aIecxs/w211-airmatic/Pinout.pdf

5V

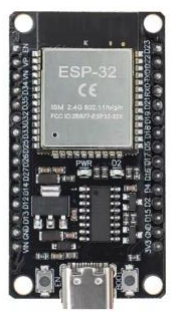
[picture p4: figure]

ESP32

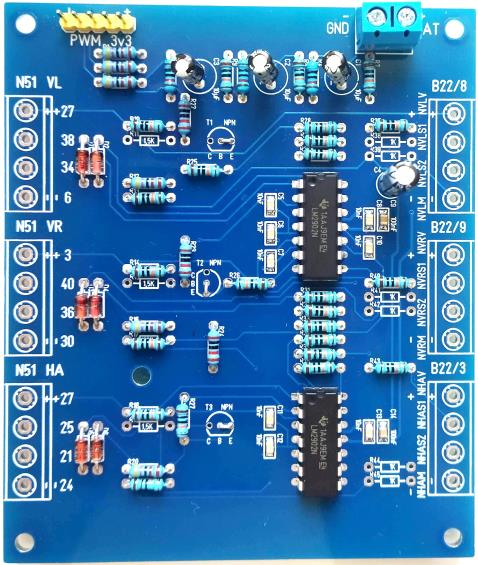
[picture p5: figure]

LM2902N

CAN-B

CAN-C

16Mhz

8Mhz

MCP2515

MCP2515

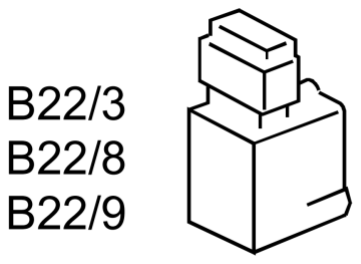
[picture p6: figure]
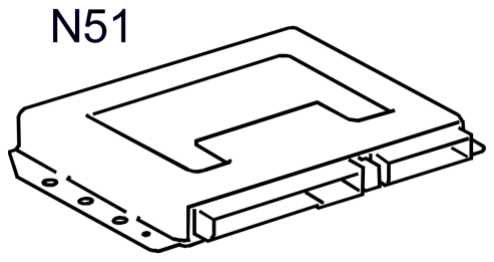
[picture p7: figure]

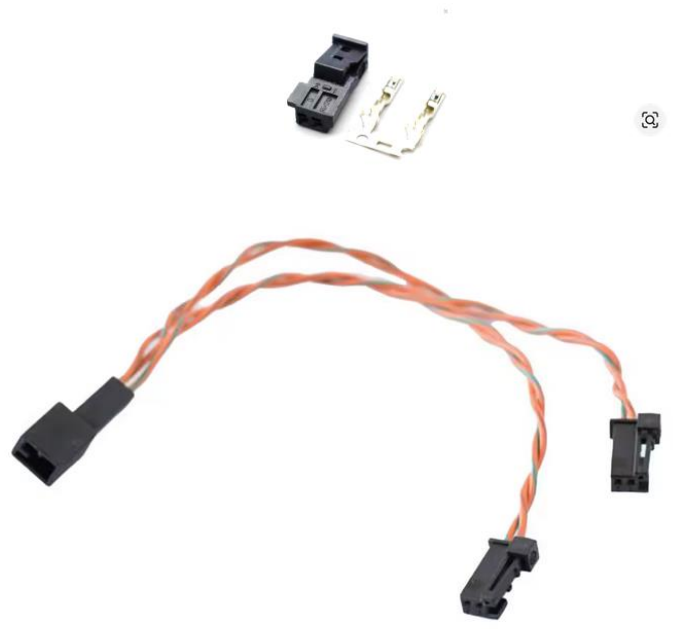
[picture p8: figure]
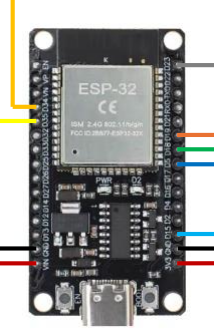
[picture p9: figure]

ESP32

16Mhz

8Mhz

MCP2515

MCP2515

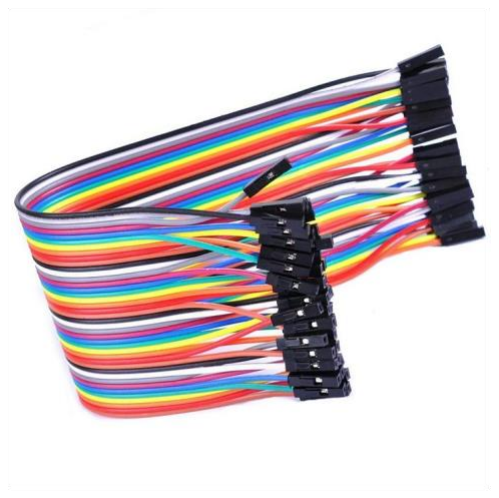
[picture p10: figure]

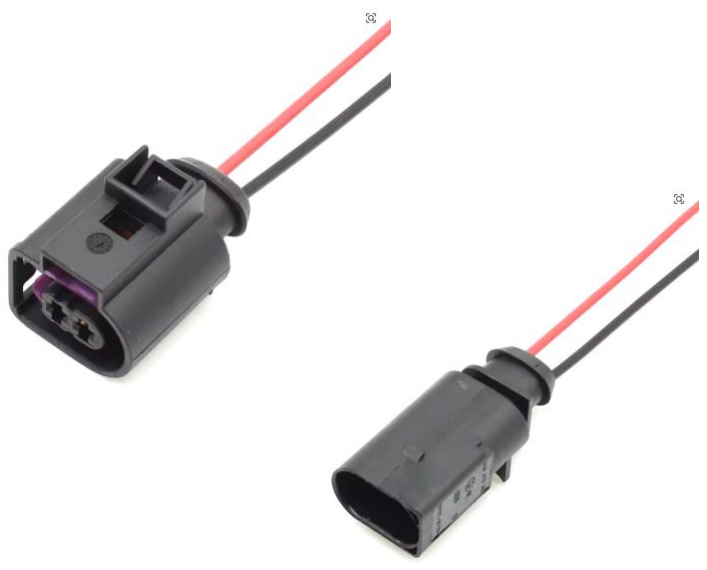
[picture p11: figure]
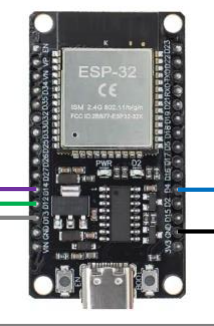
[picture p12: figure]

ESP32

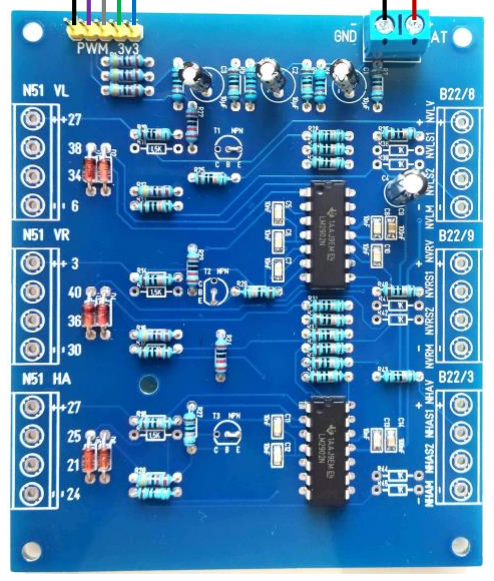
[picture p13: figure]

LM2902N

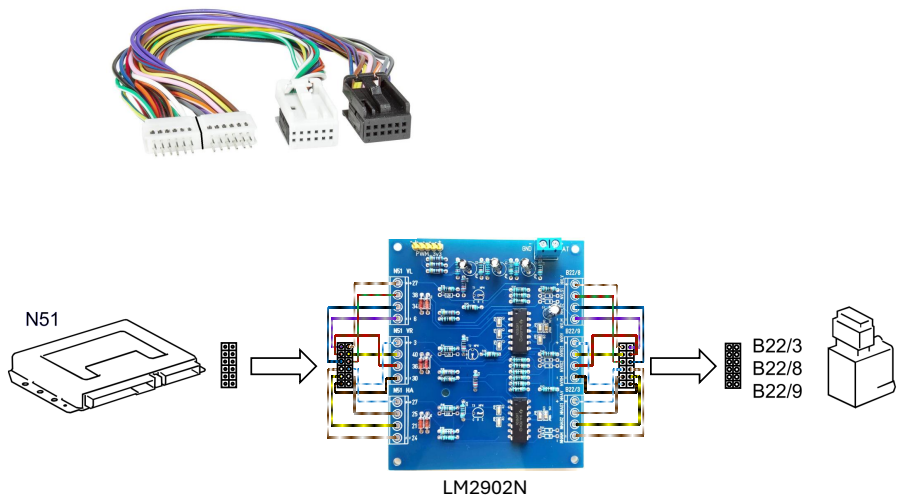
[picture p14: page 4]

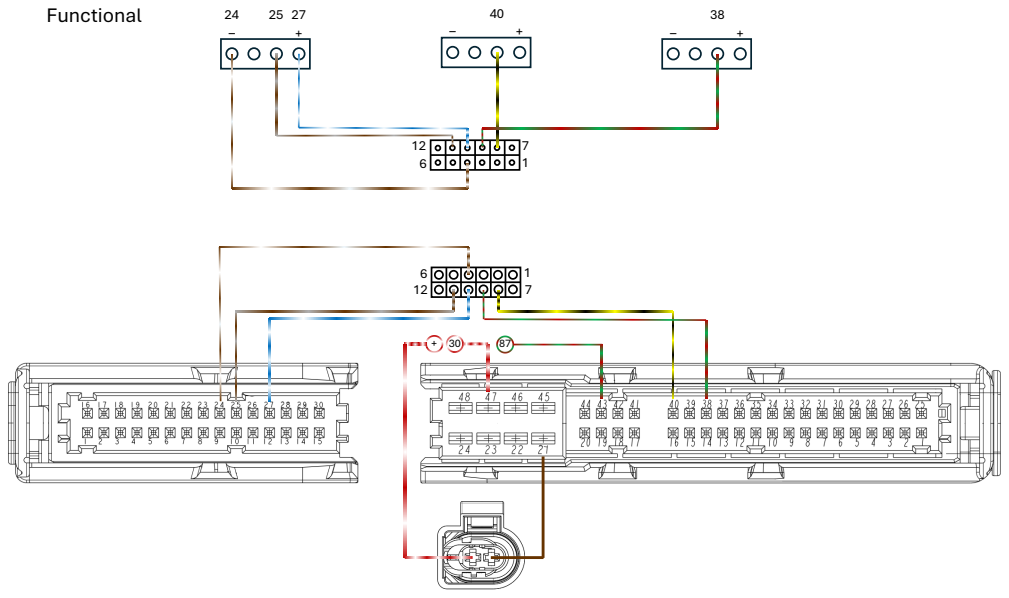
[picture p15: page 5]
Functional

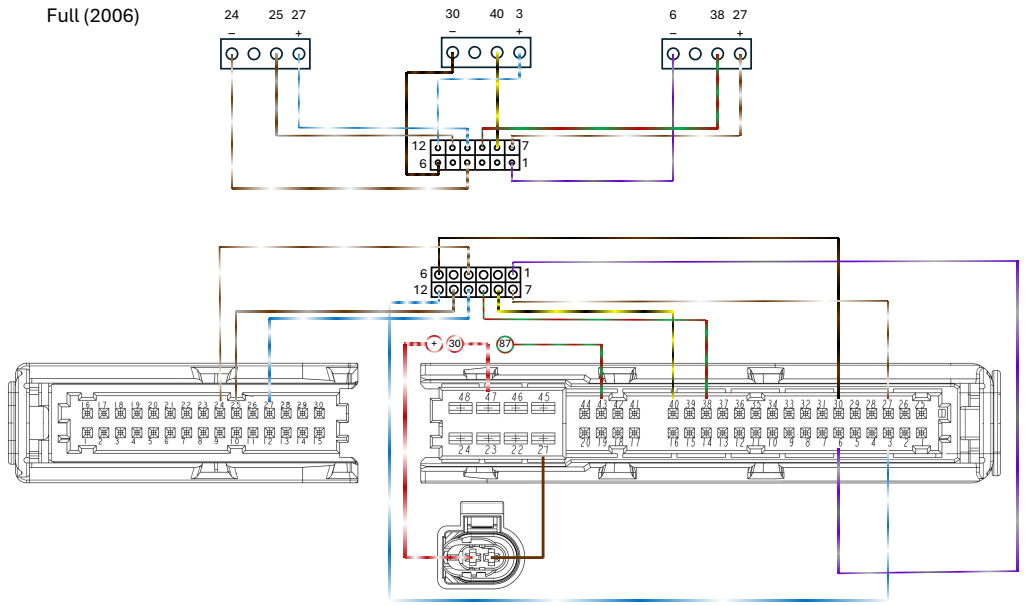
[picture p16: page 6]
Full (2006)

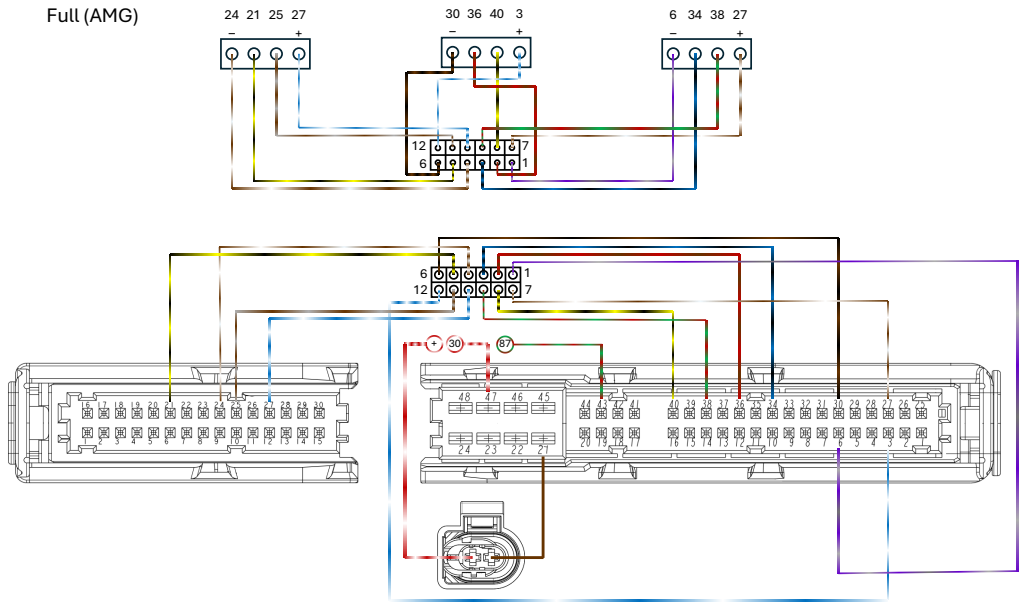
[picture p17: page 7]
Full (AMG)

## remove fan duct cover

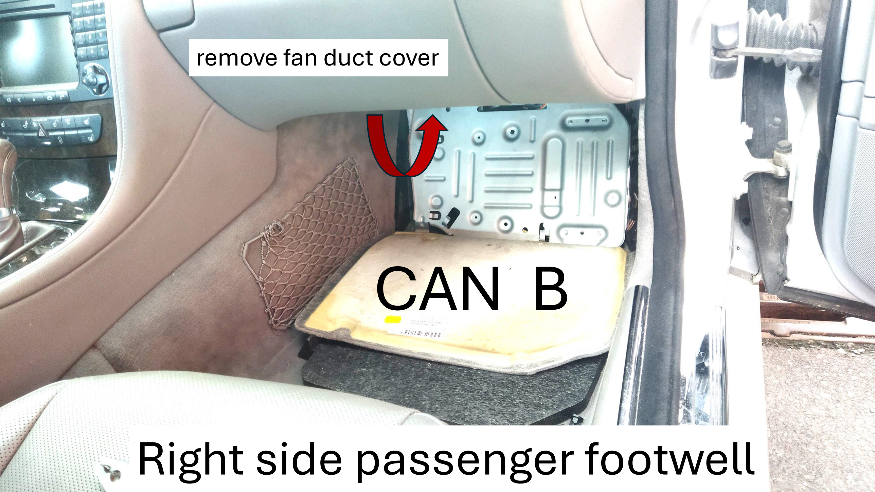
[picture p18: page 8]

# Right side passenger footwell

# CAN B

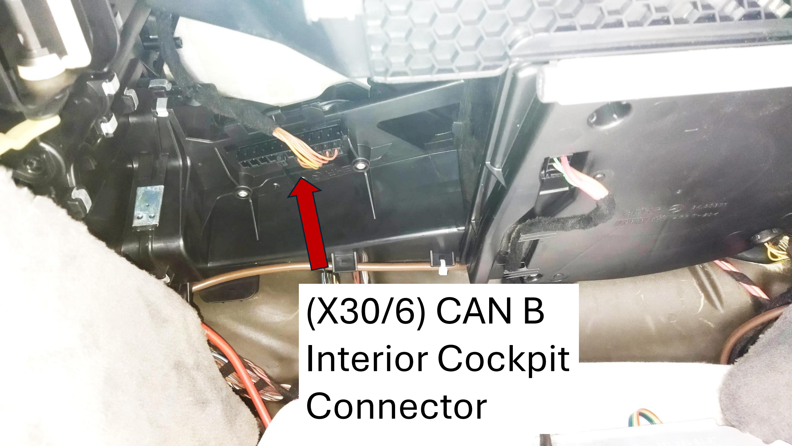
[picture p19: page 9]

# (X30/6) CAN B Interior Cockpit Connector

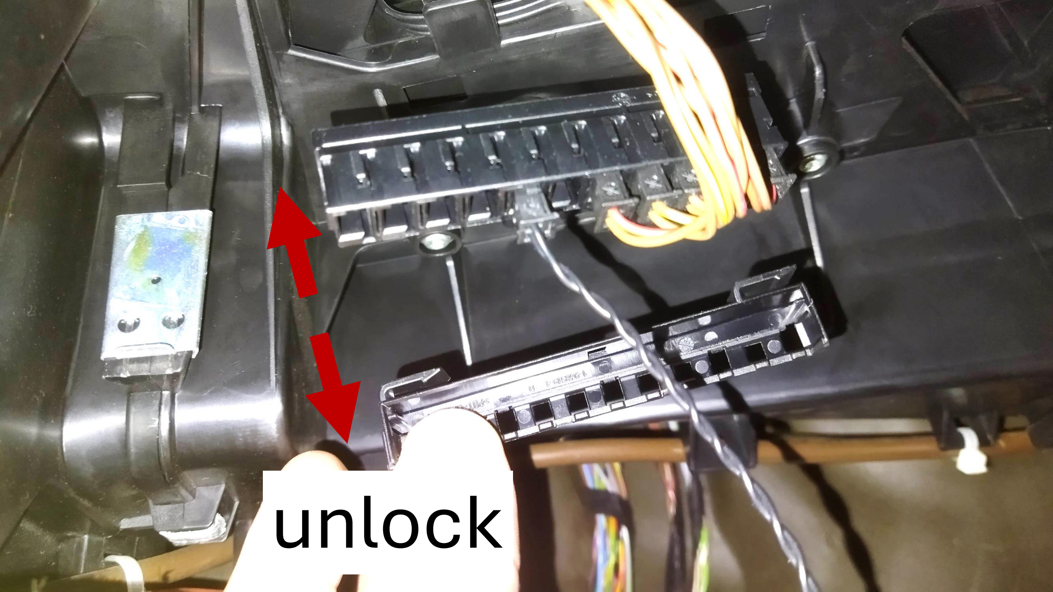
[picture p20: page 10]

# unlock

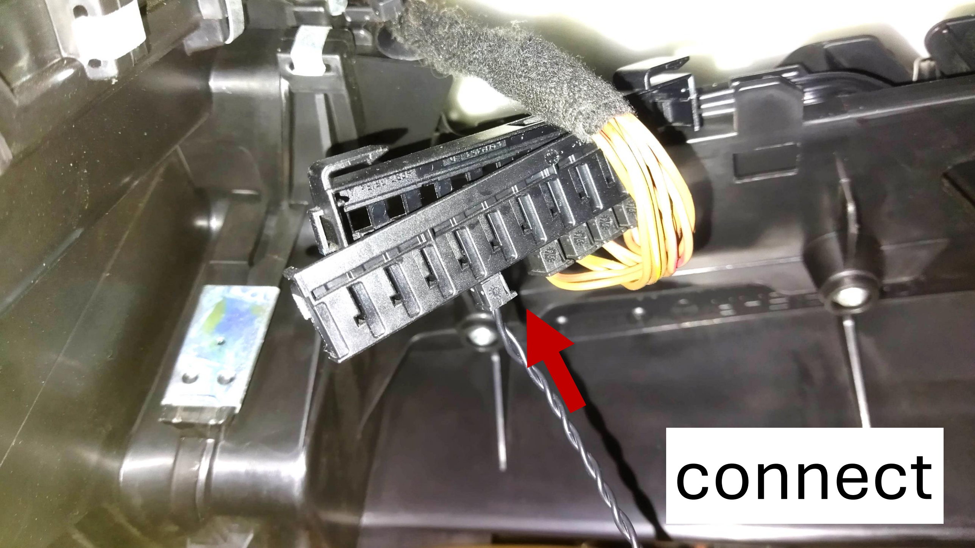
[picture p21: page 11]

# connect

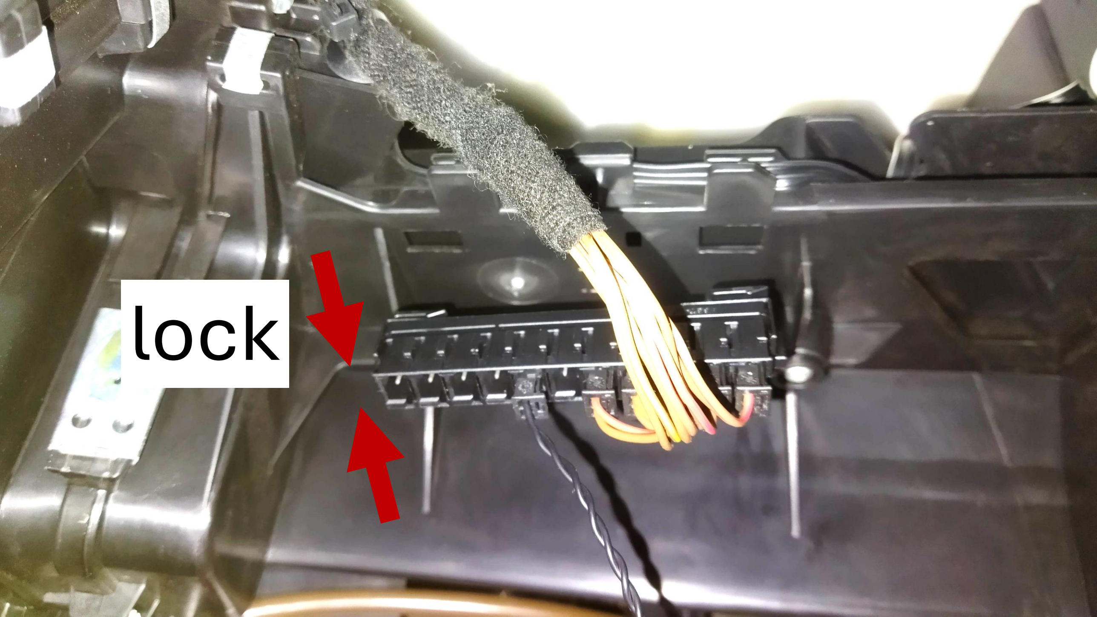
[picture p22: page 12]

# lock

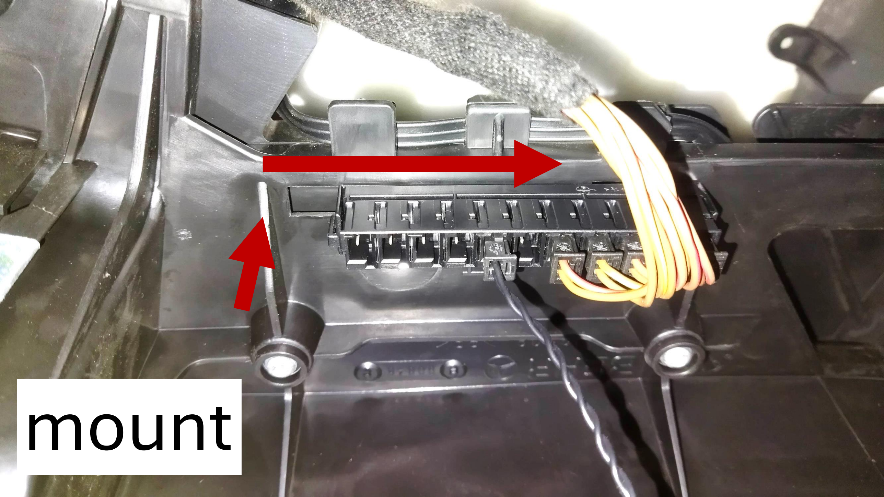
[picture p23: page 13]

# mount

# CAN C

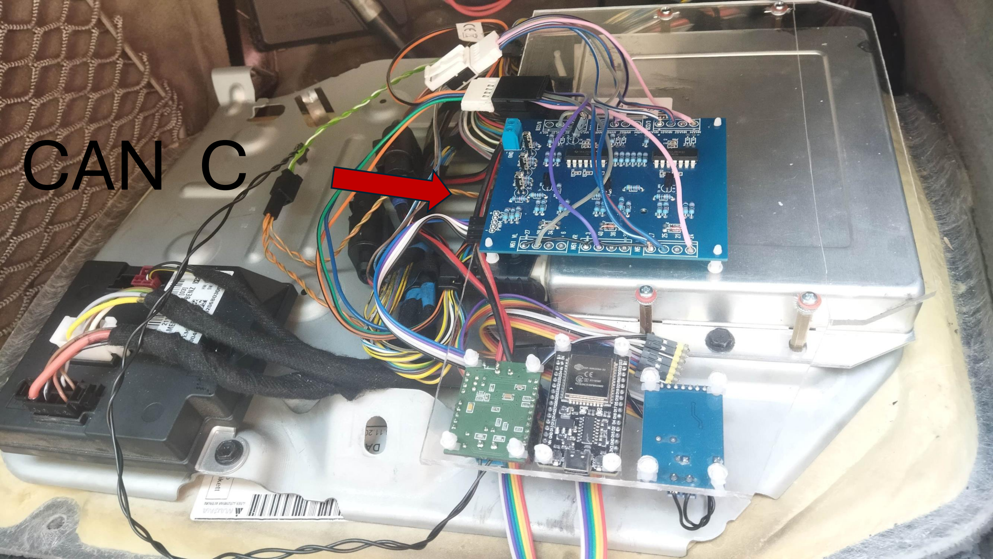
[picture p24: page 14]
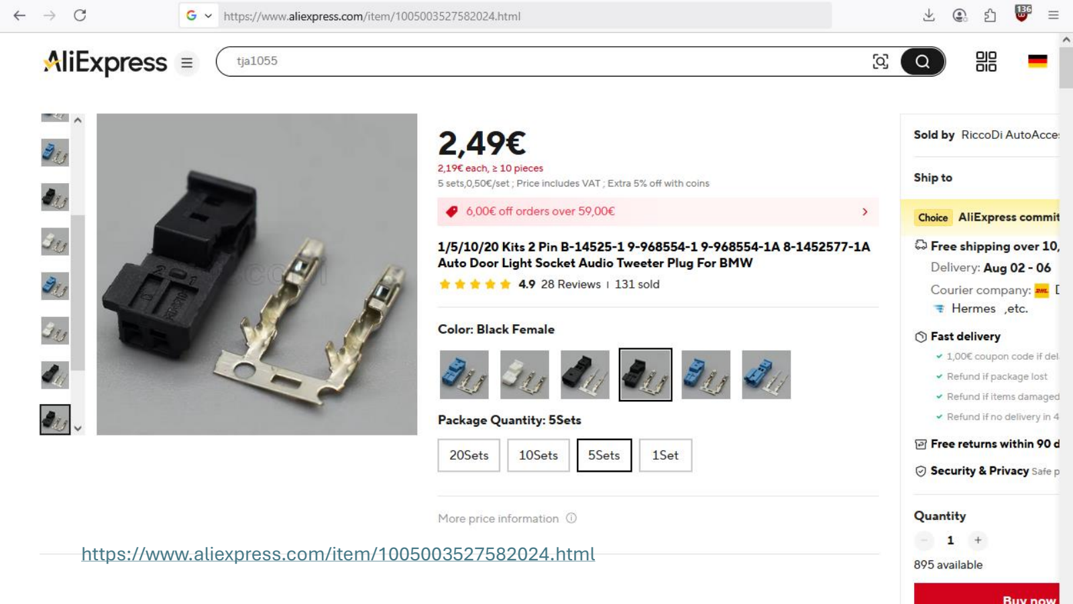
[picture p25: page 15]

https://www.aliexpress.com/item/1005003527582024.html
