aIecxs/w211-airmatic/data/button1.png

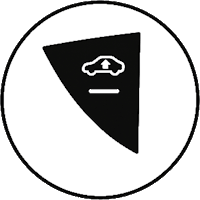
data/button1.png
