aIecxs/w211-airmatic/data/button2.png

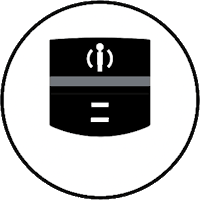
data/button2.png
