aIecxs/w211-airmatic/data/c219.png

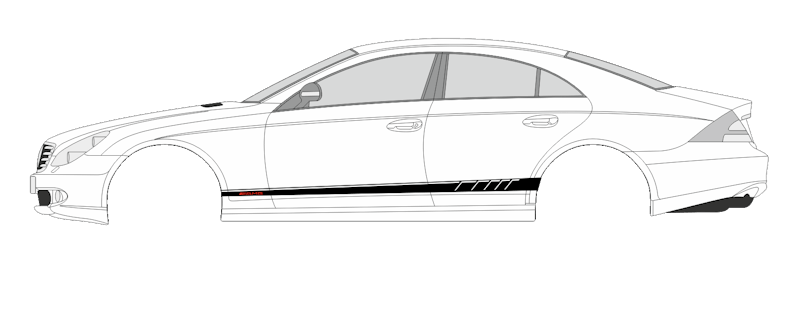
data/c219.png
