aIecxs/w211-airmatic/data/connect.png

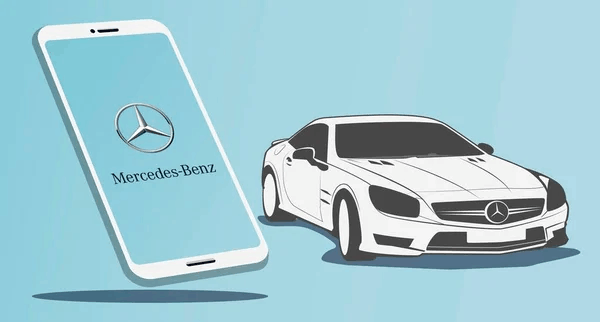
data/connect.png
