aIecxs/w211-airmatic/data/s211.png

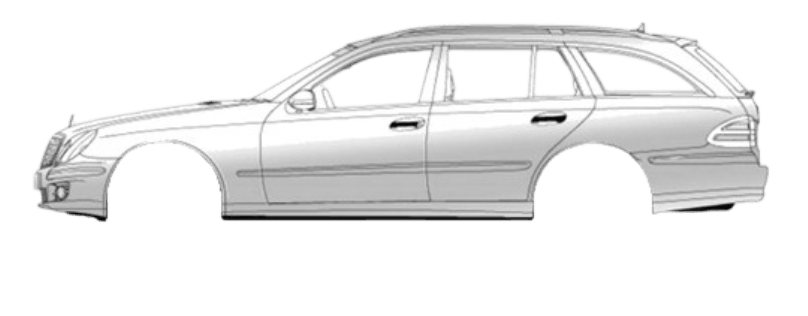
data/s211.png
