aIecxs/w211-airmatic/data/w211.png

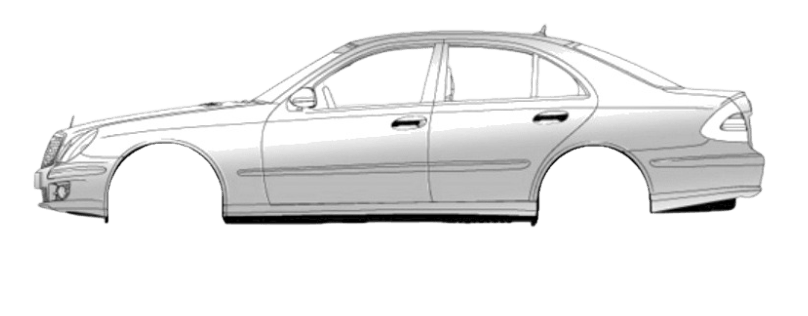
data/w211.png
