aIecxs/w211-airmatic/AIRmatic.ino

/*
 * AIRmatic Air Suspension Level Control DIY Kit
 * 
 * Author:
 * - @aIecxs
 * 
 * Credits:
 * - ArduinoJson (github.com/bblanchon/ArduinoJson)
 * - ElegantOTA (github.com/ayushsharma82/ElegantOTA)
 * - ESPAsyncWebServer (github.com/ESPAsync/ESPAsyncWebServer)
 * - AsyncTCP (github.com/ESPAsync/AsyncTCP)
 * - MCP2515 Arduino Library (github.com/autowp/arduino-mcp2515)
 * - CAN Bus reverse engineering by @rnd-ash (github.com/rnd-ash/mb-w211-pc)
 * - The Mbed TLS Contributors @adeaarm, @paul-elliott-arm (github.com/Mbed-TLS)
 * - Mbed TLS v3 legacy layer by @david-cermak (github.com/david-cermak/mbedtls_v3_shim)
 * 
 * Licensed under the MIT License.
 * Third-party libraries licensed under the LGPL-2.1 License, Apache-2.0 OR GPL-2.0-or-later
 */

#include <SPI.h>
#include <mcp2515.h>
#include <LittleFS.h>
#include <ArduinoJson.h>
#include <ESPAsyncWebServer.h>
#include "w211_can_c.h"
#include "w211_can_b.h"
#include "ic_display.h"
#include "crypt.h"

// reserved
#define LED_BUILTIN GPIO_NUM_2
#define TX0 GPIO_NUM_1 // UART0
#define RX0 GPIO_NUM_3

// MCP2515 CAN Controller Pins
#define SCK  GPIO_NUM_18 // VSPI
#define MISO GPIO_NUM_19
#define MOSI GPIO_NUM_23
#define CS0  GPIO_NUM_5  // Motor CAN-C High speed
#define INT0 GPIO_NUM_34
#define CS1  GPIO_NUM_15 // Interior CAN-B Low speed
#define INT1 GPIO_NUM_35

// TJA1055 CAN-B Transceiver Mode Pins
#define STB GPIO_NUM_21
#define EN  GPIO_NUM_22

// Watchdog
#define WO GPIO_NUM_32 // TLE4271 Watchdog out

// Enable Pin
#define ON GPIO_NUM_4  // LM2902-N Sensor signal

// Maximum Offset Limit
#define MAX_OFF 30 // mm maximum offset limit / adjust here with caution

// DAC output (offset voltage)
#define PWM1 GPIO_NUM_12 // NVLS1
#define PWM2 GPIO_NUM_13 // NVRS1
#define PWM3 GPIO_NUM_14 // NHRS1
#define PWM4 GPIO_NUM_27 // NHLS1

// CAN IDs Motor CAN-C
#define CANID0 0x0248 // ECU: ZGW, NAME: ZGW_248h, ID: 0x0248, MSG COUNT: 31
#define CANID1 0x0340 // ECU: LF_ABC, NAME: FS_340h, ID: 0x0340, MSG COUNT: 16
#define CANID4 0x0240 // ECU: EZS, NAME: EZS_240h, ID: 0x0240, MSG COUNT: 31
#define CANID5 0x0608 // ECU: MS, NAME: MS_608h, ID: 0x0608, MSG COUNT: 13

// CAN IDs Interior CAN-B
#define CANID2 0x01CA // ECU: KOMBI, NAME: KOMBI_A5, ID: 0x01CA, MSG COUNT: 25
#define CANID3 0x001A // ECU: UBF, NAME: UBF_A1, ID: 0x001A, MSG COUNT: 9
#define CANID6 0x01D0 // ECU: KOMBI, NAME: TP_KOMBI_AGW1, ID: 0x01D0. MSG COUNT: 1

#define CAN_DATA_EXPIRY_MS 1000

// copy CAN message into bit field decoder
#define copyMsg(ptr) importMsg(#ptr, ptr, sizeof(*(ptr)), id, msg, len)

/*
// helper macros for creating unique variable names
#define CONCAT_IMPL(x, y) x##y
#define CONCAT(x, y) CONCAT_IMPL(x, y)
#define delay_us(us) delay_us_INTERNAL(__COUNTER__, us)

// forward declaration so the macro can reference the class
class delayMicrosec;

// this macro instantiates a static delayMicrosec() object per call site
// identified by __COUNTER__ so each use of delay_us() has its own timer 
#define delay_us_INTERNAL(n, us) \
  static delayMicrosec CONCAT(delay_us_, n); \
  CONCAT(delay_us_, n).wait(us)
*/

#define MAILBOX_CAPACITY 16
typedef struct {
  struct can_frame frames[MAILBOX_CAPACITY];
  uint8_t head;
  uint8_t tail;
  uint8_t count;
  unsigned long timestamp;
} mbx_t;

typedef struct {
  gpio_num_t pin;
  unsigned long freq;
  unsigned char res;
} wd_ctx_t;

struct BlinkCmd {
  gpio_num_t pin;
  unsigned int ontime;
};

struct canStats_t;
extern canStats_t can0_stats;
extern canStats_t can1_stats;

constexpr unsigned int DISPLAY_NOTIFY_SERVICE = 1u << 0;
constexpr unsigned int DISPLAY_NOTIFY_COMMAND = 1u << 1;
unsigned long displayStart = 0;
bool displayEnabled = false;

enum class DisplayCommandType : uint8_t {
  Page,
  Body
};

struct DisplayCommand {
  DisplayCommandType type;
  unsigned long repeat;
  char pageText[32];
  uint8_t bodyLineCount;
  char bodyLines[4][32];
};

// CAN Frames Motor CAN-C
struct ZGW_248h_t ZGW_248h; // ECU: ZGW, NAME: ZGW_248h, ID: 0x0248, MSG COUNT: 31
struct FS_340h_t FS_340h;   // ECU: LF_ABC, NAME: FS_340h, ID: 0x0340, MSG COUNT: 16
struct EZS_240h_t EZS_240h; // ECU: EZS, NAME: EZS_240h, ID: 0x0240, MSG COUNT: 31
struct MS_608h_t MS_608h;   // ECU: MS, NAME: MS_608h, ID: 0x0608, MSG COUNT: 13

// CAN Frames Interior CAN-B
struct KOMBI_A5_t KOMBI_A5; // ECU: KOMBI, NAME: KOMBI_A5, ID: 0x01CA, MSG COUNT: 25
struct UBF_A1_t UBF_A1;     // ECU: UBF, NAME: UBF_A1, ID: 0x001A, MSG COUNT: 9
struct TP_KOMBI_AGW1_t TP_KOMBI_AGW1; // ECU: KOMBI, NAME: TP_KOMBI_AGW1, ID: 0x01D0. MSG COUNT: 1

// CAN message buffer
struct can_frame canMsg[4];

// send mailbox queue
mbx_t mbox0 = {}; // Can0
mbx_t mbox1 = {}; // Can1

// Chip select
MCP2515* Can0 = nullptr; // CS -> GPIO5
MCP2515* Can1 = nullptr; // CS -> GPIO15
bool can0 = false;
bool can1 = false;

// instrument cluster ARDUINO_CODE
IC_DISPLAY ic(new CANBUS_COMMUNICATOR(CS1, CAN_83K3BPS, CAN_B_DEF));

// PWM default value
const int freq = 4000; // 4 kHz
const uint8_t res = 8; // resolution 255
uint8_t duty = 115; // default 45% / adjust here if reference zero position for offset drifts away
int8_t calib_vl = 0; // NVLS1 calibration
int8_t calib_vr = 0; // NVRS1 calibration
int8_t calib_hr = 0; // NHRS1 calibration
int8_t calib_hl = 0; // NHLS1 calibration

// AIRmatic mode control buttons
uint8_t st2_bet = 0; // DESC: ST2_BET - LF/ABC 2-position switch actuated
uint8_t st3_bet = 0; // DESC: ST3_BET - LF/ABC 3-position switch operated

volatile bool jsonBusy = false;
String configJson;
uint8_t wheels = 0;
String fzgcod;
String mode = "default";
const char* config = "/config.json";
int8_t offset_nv = 0; // mm front axle level custom offset
int8_t offset_nh = 0; // mm rear axle level custom offset
float factor = (float) duty * 2.0 / 100.0;

volatile bool wifiConnected = false;
volatile unsigned long timer1 = 0; // millis()
volatile unsigned long timer2 = 0;

volatile bool canDown = true;
volatile int wd_counter;
portMUX_TYPE mux_wd = portMUX_INITIALIZER_UNLOCKED;
portMUX_TYPE mux_awake = portMUX_INITIALIZER_UNLOCKED;

StaticSemaphore_t spiMutexBuffer;
SemaphoreHandle_t spiMutex;
SemaphoreHandle_t canMutex;

TaskHandle_t canTask0; // Motor CAN-C
TaskHandle_t canTask1; // Interior CAN-B

TaskHandle_t wifiTask;

TaskHandle_t blinkTask;
QueueHandle_t blinkQueue;

TaskHandle_t displayTaskHandle;
QueueHandle_t displayQueue;

// import CAN message into bit field decoder
void importMsg(const char* name, void* dest, size_t destSize, unsigned int id, const uint8_t* msg, uint8_t len) {
  if (len <= destSize) {
    xSemaphoreTake(canMutex, portMAX_DELAY);
    memcpy(dest, msg, len);
    xSemaphoreGive(canMutex);
  } else {
    Serial.printf("WARNING: CANID 0x%04X (%s): frame too long, struct size is %d bytes\r\n", id, name, (int)destSize);
    delay(100);
  }
}

// export CAN message into bit field decoder
void exportMsg(unsigned int id, const uint8_t *msg, uint8_t len) {
  switch(id) {
    case CANID0:
      copyMsg(&ZGW_248h); // ECU: ZGW, NAME: ZGW_248h, ID: 0x0248, MSG COUNT: 31
      break;
    case CANID1:
      copyMsg(&FS_340h);  // ECU: LF_ABC, NAME: FS_340h, ID: 0x0340, MSG COUNT: 16
      break;
    case CANID2:
      copyMsg(&KOMBI_A5); // ECU: KOMBI, NAME: KOMBI_A5, ID: 0x01CA, MSG COUNT: 25
      break;
    case CANID3:
      copyMsg(&UBF_A1);   // ECU: UBF, NAME: UBF_A1, ID: 0x001A, MSG COUNT: 9
      break;
    case CANID4:
      copyMsg(&EZS_240h); // ECU: EZS, NAME: EZS_240h, ID: 0x0240, MSG COUNT: 31
      break;
    case CANID5:
      copyMsg(&MS_608h);  // ECU: MS, NAME: MS_608h, ID: 0x0608, MSG COUNT: 13
/*
      MS_608h.FCOD_MOT =
        (MS_608h.FCOD_MOT0 & 0x3F) | // Vehicle code engine 7Bit, Bit0-5 (Bit6 -> Signal FCOD_MOT6)
        (MS_608h.FCOD_MOT6 << 6);    // Vehicle code engine with 7 bits, bit 6
*/
      break;
    case CANID6:
      copyMsg(&TP_KOMBI_AGW1); // ECU: KOMBI, NAME: TP_KOMBI_AGW1, ID: 0x01D0. MSG COUNT: 1
      break;
  }
}

/*
// non-blocking delayMicroseconds()
class delayMicrosec {
  private:
    static constexpr uint32_t OVERHEAD_OFFSET = 40;
    static constexpr uint32_t MIN_THRESHOLD   = 50;
    esp_timer_handle_t timer;
    TaskHandle_t task;
  public:
    delayMicrosec() : timer(nullptr), task(nullptr) {}
    void wait(uint32_t us) {
      const uint32_t clamped = (us < MIN_THRESHOLD) ? MIN_THRESHOLD : us;
      const uint32_t adjusted = clamped - OVERHEAD_OFFSET;
      task = xTaskGetCurrentTaskHandle();
      xTaskNotifyStateClear(nullptr);
      if (!timer) {
        esp_timer_create_args_t args = {
          .callback = [](void* arg) {
            delayMicrosec* self = static_cast<delayMicrosec*>(arg);
            xTaskNotifyGive(self->task);
          },
          .arg = this,
          .dispatch_method = ESP_TIMER_TASK,
          .name = "delay_us_timer"
        };
        esp_timer_create(&args, &timer);
      }
      esp_timer_start_once(timer, adjusted);
      taskYIELD();
      ulTaskNotifyTake(pdTRUE, portMAX_DELAY);
    }
};
*/

// blink function: non-blocking wrapper
void blinkTaskFunc(void *param) {
  BlinkCmd cmd;
  while (true) {
    if (xQueueReceive(blinkQueue, &cmd, portMAX_DELAY) == pdTRUE) {
      bool state = digitalRead(cmd.pin);
      digitalWrite(cmd.pin, !state);
      delay(cmd.ontime);
      digitalWrite(cmd.pin, state);
    }
  }
}

// Watchdog output control timer callback
void stopWatchdog(void *arg) {

  // read args passed from startWatchdog()
  wd_ctx_t *ctx = (wd_ctx_t*)arg;
  static bool last_active = true;

  // decrease timeout counter
  portENTER_CRITICAL(&mux_wd);
  bool active = (wd_counter > 0);
  if (active) {
    wd_counter--;
  }
  portEXIT_CRITICAL(&mux_wd);

  // on timeout: stop watchdog (duty cycle = 0)
  if (active != last_active) {
    ledcWrite(ctx->pin, active ? (1UL << (ctx->res - 1)) : 0);
    last_active = active;
  }
}

// reset watchdog: requires counter = time (sec) * freq (Hz)
void feedWatchdog(unsigned long amount) {
  portENTER_CRITICAL(&mux_wd);
  wd_counter = wd_counter > static_cast<int32_t>(amount)
             ? wd_counter
             : static_cast<int32_t>(amount);
  portEXIT_CRITICAL(&mux_wd);
}

// Watchdog output pulse
void startWatchdog(gpio_num_t wpin, const unsigned long wfreq) {

  static constexpr uint32_t WATCHDOG_TIMEOUT = 10; // seconds
  static esp_timer_handle_t wd_timer = NULL;
  if (wd_timer != NULL) return; // already initialized

  const unsigned char wchn = 8;  // Group 1, Channel 0 (LEDC_LOW_SPEED_MODE)
  const unsigned char wres = 10; // resolution 1024
  const unsigned long wduty = 1UL << (wres - 1); // 50%
  ledcAttachChannel(wpin, 1000, wres, wchn);
  ledcWrite(wpin, wduty);
  ledcChangeFrequency(wpin, wfreq, wres);

  // initial feed watchdog
  feedWatchdog(WATCHDOG_TIMEOUT * wfreq);

  // args passed by pointer to the callback
  static wd_ctx_t ctx;
  ctx.pin  = wpin;
  ctx.freq = wfreq;
  ctx.res  = wres;

  // start the watchdog output control timer callback
  const esp_timer_create_args_t targs = {
    .callback = &stopWatchdog,
    .arg = &ctx,
    .dispatch_method = ESP_TIMER_TASK,
    .name = "wd_gate",
    .skip_unhandled_events = true
  };
  esp_timer_create(&targs, &wd_timer);
  esp_timer_start_periodic(wd_timer, 1000000ULL / wfreq);
}

// blink function
void blink(gpio_num_t pin, unsigned int ontime) {
  BlinkCmd cmd = {pin, ontime};
  // Try to send without blocking, drop if busy
  xQueueSend(blinkQueue, &cmd, 0);
}

// debounce key input
class GetKeyEvent {
  private:
    const bool* btn1;
    const bool* btn2;
    bool lastState = false;
    bool stableState = false;
    bool justPressed = false;
    bool repeating = false;
    unsigned long lastChange = 0;
    unsigned long lastRepeat = 0;
    const unsigned long debounceTime = 40;
    const unsigned long repeatDelay = 800;
    const unsigned long repeatInterval = 600;
  public:
    GetKeyEvent(const bool* b1, const bool* b2)
      : btn1(b1), btn2(b2) {}
    void read() {
      bool combined = (*btn1) & (*btn2);
      unsigned long time = millis();
      if (combined != lastState) {
        lastState = combined;
        lastChange = time;
      }
      if ((time - lastChange) > debounceTime) {
        if (combined != stableState) {
          stableState = combined;
          if (stableState) {
            justPressed = true;
            lastRepeat = time;
            repeating = false;
          } else {
            repeating = false;
          }
        }
      }
      if (stableState && !repeating && (time - lastRepeat) > repeatDelay) {
        repeating = true;
        lastRepeat = time;
      }
    }
    bool pressed() {
      if (justPressed) {
        justPressed = false;
        return true;
      }
      return false;
    }
    bool repeated() {
      if (repeating) {
        unsigned long time = millis();
        if ((time - lastRepeat) > repeatInterval) {
          lastRepeat = time;
          return true;
        }
      }
      return false;
    }
    bool isDown() const {
      return stableState;
    }
};

// for safety purposes - do not change
void limitOffset(int8_t* off) {
  *off = *off < -MAX_OFF ? -MAX_OFF : *off; // max suspension lowering
  *off = *off > MAX_OFF ? MAX_OFF : *off;   // max suspension height
}

/** // display offset on ic
 * @brief Sends the custom axle-level offset to the instrument cluster
 *   `0` = `select::Rear`
 *   `1` = `select::Front`
 *   `0` = `cmd::Reset`
 *   `1` = `cmd::Set`
 *   `2` = `cmd::Dn`
 *   `3` = `cmd::Up`
 * @param axle : `select::Rear`, `select::Front`
 * @param action : `cmd::Reset`, `cmd::Set`, `cmd::Dn`, `cmd::Up`
 */
void displayOffset(int axle, int action) {

  DisplayCommand params{};
  params.type = DisplayCommandType::Body;
  params.repeat = 500;

  enum class select { Rear, Front };
  enum class cmd { Reset, Set, Dn, Up };

  constexpr uint8_t num = 4;
  const char* lines[num];
  params.bodyLineCount = num;

  char offset[8];
  int8_t value = 0;

  const char* chassis = nullptr;
  const char* level = nullptr;

  if (displayQueue == nullptr || displayTaskHandle == nullptr) {
    return;
  }

  if (!displayEnabled) {
    displayInit();
  } else {
    displayStart = millis();
  }

  switch ((select)axle) {
    case select::Rear:  // MSG NAME: BUTTON_1_2 - Vorheriges Display, OFFSET 14, LENGTH 1
      chassis = "Hinten";
      value = offset_nh;
      break;
    case select::Front: // MSG NAME: BUTTON_1_1 - Nächstes Display, OFFSET 15, LENGTH 1
      chassis = "Vorn";
      value = offset_nv;
      break;
    default:
      return;
  }
  snprintf(offset, sizeof(offset), "%+dmm", (int)value);
  level = (value < 0) ? "tief" : "hoch";

  switch ((cmd)action) {
    case cmd::Reset:    // MSG NAME: BUTTON_4_2 - Telefon End, OFFSET 8, LENGTH 1
      lines[0] = "reset";
      lines[1] = mode.c_str();
      lines[2] = offset;
      lines[3] = "";
      break;
    case cmd::Set:      // MSG NAME: BUTTON_4_1 - Telefon Send, OFFSET 9, LENGTH 1
      lines[0] = "gespeichert";
      lines[1] = mode.c_str();
      lines[2] = offset;
      lines[3] = "OK";
      break;
    case cmd::Dn:       // MSG NAME: BUTTON_3_2 - Taste "-", OFFSET 10, LENGTH 1
      lines[0] = level;
      lines[1] = mode.c_str();
      lines[2] = offset;
      lines[3] = "-";
      break;
    case cmd::Up:       // MSG NAME: BUTTON_3_1 - Taste "+", OFFSET 11, LENGTH 1
      lines[0] = level;
      lines[1] = mode.c_str();
      lines[2] = offset;
      lines[3] = "+";
      break;
    default:
      return;
  }
  // async wrapper for ic.update(num, lines, 500)
  for (uint8_t i = 0; i < params.bodyLineCount; ++i) {
    snprintf(
      params.bodyLines[i],
      sizeof(params.bodyLines[i]),
      "%s",
      lines[i] != nullptr ? lines[i] : ""
    );
  }
  snprintf(params.pageText, sizeof(params.pageText), "%s", chassis);
  if (xQueueSend(displayQueue, &params, 0) == pdPASS) {
    xTaskNotify(displayTaskHandle, DISPLAY_NOTIFY_COMMAND, eSetBits);
  }
}

// async wrapper for ic.update(text)
void displayInit() {
  DisplayCommand cmd{};
  const char* text = "Niveau";
  cmd.type = DisplayCommandType::Page;
  snprintf(cmd.pageText, sizeof(cmd.pageText), "%s", text);
  displayStart = millis();
  displayEnabled = true;
  if (displayQueue == nullptr) {
    displayQueue = xQueueCreate(8, sizeof(DisplayCommand));
    if (displayQueue == nullptr) {
      return;
    }
  }
  if (displayTaskHandle == nullptr) {
    const BaseType_t result = xTaskCreate(
      displayTask,         // Task function
      "Display Task",      // name of task
      4096,                // Stack size of task
      NULL,                // parameter of the task
      1,                   // priority of the task
      &displayTaskHandle); // Task handle to keep track of created task
    if (result != pdPASS) {
      displayTaskHandle = nullptr;
      return;
    }
  }
  if (xQueueSend(displayQueue, &cmd, 0) == pdPASS) {
    xTaskNotify(displayTaskHandle, DISPLAY_NOTIFY_COMMAND, eSetBits);
  }
}

// async wrapper for ic.update() service
void displayUpdate() {
  if (displayEnabled) {
    if (millis() - displayStart > 60000UL) {
      displayEnabled = false;
      return;
    }
    if (displayTaskHandle != nullptr) {
      xTaskNotify(displayTaskHandle, DISPLAY_NOTIFY_SERVICE, eSetBits);
    }
  }
}

// async wrapper task for ic.update([<args>...])
void displayTask(void*) {
  while (true) {
    DisplayCommand cmd{};
    unsigned long notifications = 0;
    xTaskNotifyWait(
      0,
      UINT32_MAX,
      &notifications,
      portMAX_DELAY
    );
    while (xQueueReceive(displayQueue, &cmd, 0) == pdTRUE) {
      if (cmd.type == DisplayCommandType::Page) {
        // send initPage()
        ic.update(cmd.pageText);
      } else if (cmd.type == DisplayCommandType::Body) {
        const char* lines[4] = {
          cmd.bodyLines[0],
          cmd.bodyLines[1],
          cmd.bodyLines[2],
          cmd.bodyLines[3]
        };
        // replay setBodyTel() for 10 seconds
        ic.update(cmd.pageText, cmd.bodyLineCount, lines, cmd.repeat);
      }
    }
    if ((notifications & DISPLAY_NOTIFY_SERVICE) != 0) {
      // service scheduled replays from loop()
      ic.update();
    }
  }
}

// write AIRmatic mode to CAN bus
void updateMode() {
  if (st2_bet || st3_bet) {
    // do not distract ESP with CAN message replay
    if (!( EZS_240h.CRASH         ||       // Crash signal from airbag SG
           EZS_240h.CRASH_CNF     ||       // CRASH confirm bit
           EZS_240h.ASG_SPORT_BET ||       // ASG sport mode on/off actuated (ST2_LED_DL if ABC available)
           EZS_240h.BN_SOCS       ||       // Vehicle electrical system warning: starter battery state of charge
           EZS_240h.BLI_LI        ||       // Turn signal left
           EZS_240h.BLI_RE        ||       // Turn signal right
           EZS_240h.ESP_BET       ||       // ESP on/off actuated
           EZS_240h.BN_NTLF       ||       // Vehicle power supply emergency mode: Prio1 and Prio2 consumers off, second battery supports
           EZS_240h.ABL_EIN       ||       // Turn on low beam
           EZS_240h.ART_ABW_BET      )) {  // ART distance warning on/off actuated
      xSemaphoreTake(canMutex, portMAX_DELAY);
      if (st2_bet) {
        EZS_240h.ST2_BET = st2_bet & 0x03; // LF/ABC 2-position switch actuated
        st2_bet = 0;
      }
      if (st3_bet) {
        EZS_240h.ST3_BET = st3_bet & 0x03; // LF/ABC 3-position switch operated
        st3_bet = 0;
      }
      if (can0) {
        // replay last received CAN message whatever it contains + pressed AIRmatic mode button
        sendMsg(&mbox0, CANID4, &EZS_240h, sizeof(EZS_240h), 1);
      }
      xSemaphoreGive(canMutex);
      blink(LED_BUILTIN, 100);
    }
  }
}

// read config.json file from LittleFS
JsonDocument readConfig() {
  for (uint8_t i = 0; jsonBusy && i < 10; i++) {
    delay(5);
  }
  if (!jsonBusy) {
    jsonBusy = true;
    JsonDocument doc;
    File file = LittleFS.open(config, "r");
    if (!file) {
      Serial.print("LittleFS: cannot access '");
      Serial.print(config);
      Serial.println("': No such file or directory");
      configJson = "{}";
      jsonBusy = false;
      return doc;
    }
    DeserializationError err = deserializeJson(doc, file);
    file.seek(0);
    configJson = file.readString();
    file.close();
    if (err) {
      Serial.print("Cannot deserialize the current JSON object: ");
      Serial.println(err.c_str());
    }
    jsonBusy = false;
    return doc;
  }
  Serial.print("LittleFS: error reading file '");
  Serial.print(config);
  Serial.println("': JSON object timeout: 'configJson'");
  JsonDocument emptyDoc;
  return emptyDoc;
}

// write config.json file to LittleFS
void saveConfig(const JsonDocument& doc) {
  File file = LittleFS.open(config, "w");
  if (!file) {
    Serial.print("LittleFS: ");
    Serial.print(config);
    Serial.println(": Read-only file system");
    return;
  }
  serializeJson(doc, file);
  file.close();
}

// read Chassis and Wheels PNG from LittleFS
void getPNG() {
  JsonDocument doc = readConfig();
  fzgcod = "";
  wheels = 0;
  if (doc.containsKey("fcod_br")) {
    fzgcod = doc["fcod_br"].as<String>();
  }
  if (doc.containsKey("wheels")) {
    wheels = doc["wheels"];
  }
}

// save Chassis and Wheels PNG to LittleFS
void updatePNG() {
  JsonDocument doc = readConfig();
  doc["fcod_br"].set(fzgcod);
  doc["wheels"] = wheels;
  saveConfig(doc);
}

void getCalibration() {
  JsonDocument doc = readConfig();
  calib_vl = 0;
  calib_vr = 0;
  calib_hl = 0;
  calib_hr = 0;
  if (!doc.containsKey("calibration")) return;
  JsonObject obj = doc["calibration"];
  if (obj.containsKey("calib_vl")) calib_vl = obj["calib_vl"];
  if (obj.containsKey("calib_vr")) calib_vr = obj["calib_vr"];
  if (obj.containsKey("calib_hl")) calib_hl = obj["calib_hl"];
  if (obj.containsKey("calib_hr")) calib_hr = obj["calib_hr"];
}

void updateCalibration(const String& key, int8_t value) {
  JsonDocument doc = readConfig();
  JsonObject calibObj;
  if (doc.containsKey("calibration")) {
    calibObj = doc["calibration"];
  } else {
    calibObj = doc.createNestedObject("calibration");
  }
  calibObj[key] = value;
  saveConfig(doc);
}

// read table
void getSettings(const String& mode) {
  JsonDocument doc = readConfig();
  offset_nv = 0;
  offset_nh = 0;
  if (!doc.containsKey(mode)) return;
  JsonObject obj = doc[mode];
  if (obj.containsKey("offset_nv")) offset_nv = obj["offset_nv"];
  if (obj.containsKey("offset_nh")) offset_nh = obj["offset_nh"];
}

// write table
void updateSettings(const String& mode, const String& offset, int8_t value) {
  JsonDocument doc = readConfig();
  JsonObject modeObj;
  if (doc.containsKey(mode)) {
    modeObj = doc[mode];
  } else {
    modeObj = doc.createNestedObject(mode);
  }
  modeObj[offset] = value;
  saveConfig(doc);
}

// read wifi credentials from config.json file
void getWifi(String &hash_old, String &seed_old) {
  JsonDocument doc = readConfig();
  hash_old = "";
  seed_old = "";
  if (!doc.containsKey("wifi")) return;
  JsonObject obj = doc["wifi"];
  if (obj.containsKey("hash")) hash_old = obj["hash"].as<String>();
  if (obj.containsKey("seed")) seed_old = obj["seed"].as<String>();
}

// write wifi credentials to config.json file
void updateWifi(const String &hash_new, const String &seed_new) {
  JsonDocument doc = readConfig();
  JsonObject wifiObj;
  if (doc.containsKey("wifi")) {
    wifiObj = doc["wifi"];
  } else {
    wifiObj = doc.createNestedObject("wifi");
  }
  wifiObj["hash"].set(hash_new);
  wifiObj["seed"].set(seed_new);
  saveConfig(doc);
}

// Interrupt based CanRx
void IRAM_ATTR onCanInterrupt0();
void IRAM_ATTR onCanInterrupt1();

// power down no CAN traffic
void go_to_sleep(unsigned int timeout) {
  if ( millis() - timer1 > timeout ) {
    portENTER_CRITICAL(&mux_awake);
    timer1 = millis();
    timer2 = timer1;
    canDown = true;
    portEXIT_CRITICAL(&mux_awake);
    digitalWrite(LED_BUILTIN, LOW);
    Serial.println("Can: timeout ... no traffic");
    // put TJA1055 into go-to-sleep
    if (!wifiConnected) {
      digitalWrite(STB, LOW);
      delay(1);
      digitalWrite(EN, LOW);
    }
  }
}

// keep awake CAN traffic
void awake(unsigned int delayMs) {
  bool wakeup = false;
  if ( millis() - timer2 > delayMs ) {
    portENTER_CRITICAL(&mux_awake);
    timer2 = millis();
    timer1 = timer2;
    if (canDown) {
      canDown = false;
      wakeup = true;
    }
    portEXIT_CRITICAL(&mux_awake);
    if (wakeup) {
      // put TJA1055 into Normal Mode
      digitalWrite(STB, HIGH);
      digitalWrite(EN, HIGH);
      digitalWrite(LED_BUILTIN, HIGH);
      wakeup = false;
    }
  }
}


void setup() {

  // Watchdog output 1 Hz
  startWatchdog(WO, 1);

  pinMode(LED_BUILTIN, OUTPUT);

  Serial.begin(115200, SERIAL_8N1, RX0, TX0);
  SPI.begin(SCK, MISO, MOSI);

  /* SPI flash file system
  |--------------|-------|---------------|--|--|--|--|--|
  ^              ^       ^               ^     ^
  Sketch    OTA update   File system   EEPROM  WiFi config (SDK) */
  LittleFS.begin(true);

  // Normal Mode TJA1055
  pinMode(EN, OUTPUT);
  pinMode(STB, OUTPUT);
  digitalWrite(EN, HIGH);
  digitalWrite(STB, HIGH);

  // protects shared SPI access between Can0, Can1
  spiMutex = xSemaphoreCreateMutexStatic(&spiMutexBuffer);

  // thread-safe access can data structs
  canMutex = xSemaphoreCreateMutex();

  // debug can stats
  initCanStatsMutexes();

  Can0 = new MCP2515(CS0); // CS -> GPIO5
  Can1 = new MCP2515(CS1); // CS -> GPIO15

  can0 = (Can0->reset() == MCP2515::ERROR_OK);
  can1 = (Can1->reset() == MCP2515::ERROR_OK);
  delay(1);

  Can0->setBitrate(CAN_500KBPS, MCP_8MHZ); // Motor CAN-C High speed
  Can1->setBitrate(CAN_83K3BPS, MCP_16MHZ); // Interior CAN-B Low speed

  // Filters for Receive Buffer RXB0 (uses MASK0, filters RXF0 and RXF1)
  Can0->setFilterMask(MCP2515::MASK0, false, 0x7FF); // Standard ID mask = 11 bits
  Can0->setFilter(MCP2515::RXF0, false, CANID0); // ECU: ZGW, NAME: ZGW_248h, ID: 0x0248, MSG COUNT: 31
  Can0->setFilter(MCP2515::RXF1, false, CANID1); // ECU: LF_ABC, NAME: FS_340h, ID: 0x0340, MSG COUNT: 16

  // Filters for Receive Buffer RXB1 (uses MASK1, filters RXF2 to RXF5)
  Can0->setFilterMask(MCP2515::MASK1, false, 0x7FF); // Standard ID mask = 11 bits
  Can0->setFilter(MCP2515::RXF2, false, CANID0); // ECU: ZGW, NAME: ZGW_248h, ID: 0x0248, MSG COUNT: 31
  Can0->setFilter(MCP2515::RXF3, false, CANID1); // ECU: LF_ABC, NAME: FS_340h, ID: 0x0340, MSG COUNT: 16
  Can0->setFilter(MCP2515::RXF4, false, CANID4); // ECU: EZS, NAME: EZS_240h, ID: 0x0240, MSG COUNT: 31
  Can0->setFilter(MCP2515::RXF5, false, CANID5); // ECU: MS, NAME: MS_608h, ID: 0x0608, MSG COUNT: 13

  // Filters for Receive Buffer RXB0 (uses MASK0, filters RXF0 and RXF1)
  Can1->setFilterMask(MCP2515::MASK0, false, 0x7FF); // Standard ID mask = 11 bits
  Can1->setFilter(MCP2515::RXF0, false, CANID2); // ECU: KOMBI, NAME: KOMBI_A5, ID: 0x01CA, MSG COUNT: 25
  Can1->setFilter(MCP2515::RXF1, false, CANID3); // ECU: UBF, NAME: UBF_A1, ID: 0x001A, MSG COUNT: 9

  // Filters for Receive Buffer RXB1 (uses MASK1, filters RXF2 to RXF5)
  Can1->setFilterMask(MCP2515::MASK1, false, 0x7FF); // Standard ID mask = 11 bits
  Can1->setFilter(MCP2515::RXF2, false, CANID2); // ECU: KOMBI, NAME: KOMBI_A5, ID: 0x01CA, MSG COUNT: 25
  Can1->setFilter(MCP2515::RXF3, false, CANID3); // ECU: UBF, NAME: UBF_A1, ID: 0x001A, MSG COUNT: 9
  Can1->setFilter(MCP2515::RXF4, false, CANID6); // ECU: KOMBI, NAME: TP_KOMBI_AGW1, ID: 0x01D0. MSG COUNT: 1

  if (Can0->setNormalOneShotMode() == MCP2515::ERROR_OK) {
    Serial.println("MCP2515 initialized");
  } else {
    Serial.println("WARNING: MCP2515 not initialized");
  }
  if (Can1->setNormalOneShotMode() == MCP2515::ERROR_OK) {
    Serial.println("MCP2515 initialized");
  } else {
    Serial.println("WARNING: MCP2515 not initialized");
  }

  // MCP2515 Interrupts
  pinMode(INT0, INPUT);
  pinMode(INT1, INPUT);
  attachInterrupt(digitalPinToInterrupt(INT0), onCanInterrupt0, FALLING);
  attachInterrupt(digitalPinToInterrupt(INT1), onCanInterrupt1, FALLING);

  if (can0) {
    // create a task that will be executed along the loop() function, with priority 2 and executed on core 0
    xTaskCreatePinnedToCore(
      canEvent0,     // Task function
      "Can0 Events", // name of task
      4096,          // Stack size of task
      NULL,          // parameter of the task
      2,             // priority of the task
      &canTask0,     // Task handle to keep track of created task
      0);            // pin task to core 0
  }

  if (can1) {
    // create a task that will be executed along the loop() function, with priority 2 and executed on core 1
    xTaskCreatePinnedToCore(
      canEvent1,     // Task function
      "Can1 Events", // name of task
      4096,          // Stack size of task
      NULL,          // parameter of the task
      2,             // priority of the task
      &canTask1,     // Task handle to keep track of created task
      1);            // pin task to core 1
  }

  (void) readConfig();
  wifiSetup();

  // create a task that will be executed along the loop() function, with priority 1
  xTaskCreate(
    wifiEvent,     // Task function
    "WiFi Event",  // name of task
    16384,         // Stack size of task
    NULL,          // parameter of the task
    1,             // priority of the task
    &wifiTask);    // Task handle to keep track of created task

  // create a task that will be executed along the loop() function, with priority 1
  blinkQueue = xQueueCreate(1, sizeof(BlinkCmd));
  xTaskCreate(
    blinkTaskFunc, // Task function
    "blinkTask",   // name of task
    2048,          // Stack size of task
    NULL,          // parameter of the task
    1,             // priority of the task
    &blinkTask);   // Task handle to keep track of created task

  // DAC offset: Vref on
  pinMode(ON, OUTPUT);
  digitalWrite(ON, HIGH);

  // DAC offset voltage generator 4 kHz
  ledcAttach(PWM1, freq, res);
  ledcAttach(PWM2, freq, res);
  ledcAttach(PWM3, freq, res);
  ledcAttach(PWM4, freq, res);

  Serial.println("full source code available at -> github.com/aiecxs/w211-airmatic");
}


void loop() {

  static bool isInPage;
  static uint8_t ic_stat = 255;
  static String lastMode = mode;
  static unsigned long timeMs = millis();

  // temp buttons: map bitfield bools into regular bools
  static bool button0 = 0; // MSG NAME: BUTTON_4_2 - Telefon End, OFFSET 8, LENGTH 1
  static bool button1 = 0; // MSG NAME: BUTTON_4_1 - Telefon Send, OFFSET 9, LENGTH 1
  static bool button2 = 0; // MSG NAME: BUTTON_3_2 - Taste "-", OFFSET 10, LENGTH 1
  static bool button3 = 0; // MSG NAME: BUTTON_3_1 - Taste "+", OFFSET 11, LENGTH 1
//  static bool button4 = 0; // MSG NAME: BUTTON_2_2 - Reserve, OFFSET 12, LENGTH 1
//  static bool button5 = 0; // MSG NAME: BUTTON_2_1 - Reserve, OFFSET 13, LENGTH 1
  static bool button6 = 0; // MSG NAME: BUTTON_1_2 - Vorheriges Display, OFFSET 14, LENGTH 1
  static bool button7 = 0; // MSG NAME: BUTTON_1_1 - Nächstes Display, OFFSET 15, LENGTH 1

  // declare key combinations
  static GetKeyEvent keyComboRearReset(&button0, &button6);
  static GetKeyEvent keyComboFrontReset(&button0, &button7);
  static GetKeyEvent keyComboRearSet(&button1, &button6);
  static GetKeyEvent keyComboFrontSet(&button1, &button7);
  static GetKeyEvent keyComboRearDn(&button2, &button6);
  static GetKeyEvent keyComboFrontDn(&button2, &button7);
  static GetKeyEvent keyComboRearUp(&button3, &button6);
  static GetKeyEvent keyComboFrontUp(&button3, &button7);

  // main loop
  if (!fzgcod.length()) {
    getPNG();
  }
  if (MS_608h.FCOD_BR == 23) {
    fzgcod = "C219";
  } else if (MS_608h.FCOD_KAR == 3) {
    fzgcod = "S211";
  } else if (MS_608h.FCOD_BR == 13) {
    fzgcod = "W211";
  } else if (!fzgcod.length()) {
    fzgcod = "W211";
  }

  if (EZS_240h.KL_15) {
    if (FS_340h.FS_ID == 2) {

      // todo: check the KOMBI_A9 IPS Mode (Comfort/Sport)
      mode = "comfort";

    } else if (FS_340h.FS_ID == 1) {
      // check the AIRmatic mode (Offroad/Comfort/Sport1/Sport2)
      if (FS_340h.ST2_LED_DL) {
        mode = "offroad";
      } else if (FS_340h.ST3_LEDR_DL) {
        mode = "sport2";
      } else if (FS_340h.ST3_LEDL_DL) {
        mode = "sport1";
      } else {
        mode = "comfort";
      }
    }
  } else {
    mode = "default";
  }

  // read offsets from table
  if (mode != lastMode) {
    lastMode = mode;
    // on table: apply offsets
    getSettings(mode);
    limitOffset(&offset_nv);
    limitOffset(&offset_nh);
    Serial.print("mode = "); Serial.println(mode);
    Serial.print("offset_nv = "); Serial.print(offset_nv, DEC); Serial.println(" mm front axle level custom offset");
    Serial.print("offset_nh = "); Serial.print(offset_nh, DEC); Serial.println(" mm rear axle level custom offset");
    blink(LED_BUILTIN, 100);
  }

  // check display is in phone mode
  if ((KOMBI_A5.KI_STAT != ic_stat) && KOMBI_A5.KI_STAT) {
    isInPage = false;
    ic_stat = KOMBI_A5.KI_STAT;
    KOMBI_A5.KI_STAT = 0;
  }
  if ((ic_stat == 5) && isInPage) {
    // get keyevents
    // FRONT + HIGHER
    button7 = KOMBI_A5.BUTTON_1_1;
    button3 = KOMBI_A5.BUTTON_3_1;
    keyComboFrontUp.read();
    if (keyComboFrontUp.pressed() || keyComboFrontUp.repeated()) {
      offset_nv += 5; // increase
      limitOffset(&offset_nv);
      Serial.print("offset_nv = "); Serial.print(offset_nv, DEC); Serial.println(" mm front axle level custom offset");
      blink(LED_BUILTIN, 100);
      displayOffset(1, 3); // select::Front + cmd::Up
    }
    // FRONT + LOWER
    button7 = KOMBI_A5.BUTTON_1_1;
    button2 = KOMBI_A5.BUTTON_3_2;
    keyComboFrontDn.read();
    if (keyComboFrontDn.pressed() || keyComboFrontDn.repeated()) {
      offset_nv -= 5; // decrease
      limitOffset(&offset_nv);
      Serial.print("offset_nv = "); Serial.print(offset_nv, DEC); Serial.println(" mm front axle level custom offset");
      blink(LED_BUILTIN, 100);
      displayOffset(1, 2); // select::Front + cmd::Dn
    }
    // REAR + HIGHER
    button6 = KOMBI_A5.BUTTON_1_2;
    button3 = KOMBI_A5.BUTTON_3_1;
    keyComboRearUp.read();
    if (keyComboRearUp.pressed() || keyComboRearUp.repeated()) {
      offset_nh += 5; // increase
      limitOffset(&offset_nh);
      Serial.print("offset_nh = "); Serial.print(offset_nh, DEC); Serial.println(" mm rear axle level custom offset");
      blink(LED_BUILTIN, 100);
      displayOffset(0, 3); // select::Rear + cmd::Up
    }
    // REAR + LOWER
    button6 = KOMBI_A5.BUTTON_1_2;
    button2 = KOMBI_A5.BUTTON_3_2;
    keyComboRearDn.read();
    if (keyComboRearDn.pressed() || keyComboRearDn.repeated()) {
      offset_nh -= 5; // decrease
      limitOffset(&offset_nh);
      Serial.print("offset_nh = "); Serial.print(offset_nh, DEC); Serial.println(" mm rear axle level custom offset");
      blink(LED_BUILTIN, 100);
      displayOffset(0, 2); // select::Rear + cmd::Dn
    }
    // on confirm: write offsets to table
    // FRONT + SAVE
    button7 = KOMBI_A5.BUTTON_1_1;
    button1 = KOMBI_A5.BUTTON_4_1;
    keyComboFrontSet.read();
    if (keyComboFrontSet.repeated()) {
      Serial.print("offset_nv = "); Serial.print(offset_nv, DEC); Serial.println(" mm front axle -> SET");
      updateSettings(mode, "offset_nv", offset_nv);
      blink(LED_BUILTIN, 100);
      displayOffset(1, 1); // select::Front + cmd::Set
    }
    // REAR + SAVE
    button6 = KOMBI_A5.BUTTON_1_2;
    button1 = KOMBI_A5.BUTTON_4_1;
    keyComboRearSet.read();
    if (keyComboRearSet.repeated()) {
      Serial.print("offset_nh = "); Serial.print(offset_nh, DEC); Serial.println(" mm rear axle -> SET");
      updateSettings(mode, "offset_nh", offset_nh);
      blink(LED_BUILTIN, 100);
      displayOffset(0, 1); // select::Rear + cmd::Set
    }
    // FRONT + CANCEL
    button7 = KOMBI_A5.BUTTON_1_1;
    button0 = KOMBI_A5.BUTTON_4_2;
    keyComboFrontReset.read();
    if (keyComboFrontReset.pressed()) {
      offset_nv = 0;
      Serial.print("offset_nv = "); Serial.print(offset_nv, DEC); Serial.println(" mm front axle -> SET");
      updateSettings(mode, "offset_nv", offset_nv);
      blink(LED_BUILTIN, 100);
      displayOffset(1, 0); // select::Front + cmd::Reset
    }
    // REAR + CANCEL
    button6 = KOMBI_A5.BUTTON_1_2;
    button0 = KOMBI_A5.BUTTON_4_2;
    keyComboRearReset.read();
    if (keyComboRearReset.pressed()) {
      offset_nh = 0;
      Serial.print("offset_nh = "); Serial.print(offset_nh, DEC); Serial.println(" mm rear axle -> SET");
      updateSettings(mode, "offset_nh", offset_nh);
      blink(LED_BUILTIN, 100);
      displayOffset(0, 0); // select::Rear + cmd::Reset
    }
    displayUpdate();
    if (!displayEnabled) {
      ic_stat = 255;
    }
  } else if (ic_stat == 5) {
    isInPage = true;
    displayInit();
  }

  // DAC offset voltage output
  if ( millis() - timeMs > 500 ) {
    timeMs = millis();
    ledcWrite(PWM1, duty + calib_vl + offset_nv * factor); // NVLS1
    ledcWrite(PWM2, duty + calib_vr - offset_nv * factor); // NVRS1 / inverted, requires negative offset
    ledcWrite(PWM3, duty + calib_hr + offset_nh * factor); // NHRS1
    ledcWrite(PWM4, duty + calib_hl - offset_nh * factor); // NHLS1 / not available for 211/219

    if (can0) clearCan0(CAN_DATA_EXPIRY_MS);
    if (can1) clearCan1(CAN_DATA_EXPIRY_MS);

    feedWatchdog(10); // 10 sec
  }

  // put TJA1055 into go-to-sleep / TJA1055 does the rest and will switch off TLE4271 automatically
  go_to_sleep(10000); // 10 sec

  // reset ESP32 once a week
  if (timeMs > 600000000) {
    scheduleReboot(5000);
  }
  handleReboot();
  delay(10);
}
