aIecxs/w211-airmatic/(commit log)

2013-02-07 convenience methods for polygon and curve now properly translate and center objects. Every shape is centered when placed on the stage
2013-08-08 broke apart the prototype for vector
2014-01-29 Fixed interpretation of curved shapes with holes
2014-02-13 updated subdivide to accept relative anchors and added a test for holes
2014-04-15 added id case to Two.Utils.applySvgAttributes per issue 73
2014-04-21 ensured uniqueness per Two.Polygon.Properties on Two.Group.prototype
2017-03-31 use node’s global object if it exists
2017-05-24 added complete function for sprite playback to create chainable events
2017-08-03 current fix for pattern indentification
2018-05-25 added proper constructors to all Two.js classes prototypes
2019-11-07 Prototype for 2 MCP2515's on 1 arduino (Can C + Can B)
2019-11-10 3.0.0
    MAJOR update! Too many changes to list here. Please see https://greensock.com/3-release-notes for details.
    Just a few highlights:
    - New MotionPathPlugin
    - No more TweenLite, TweenMax, TimelineLite, and TimelineMax - they’ve been consolidated into a single “gsap” object that’s easier to work with.
    - Loads of new utility methods
    - Keyframes
    - New, more concise ease syntax
    - LOTS more.
    Although mostly backward-compatible with legacy code, there are some breaking changes, plus there’s a newer, more concise syntax that we strongly recommend moving to.
    Happy tweening!
2019-11-12 intial stages for DIAG mode
2019-11-28 BHP and Torque calculation
2019-11-29 Updated BHP/Torque calculation, Store more values in PROGMEM
2020-01-09 3.0.5
    - NEW: gsap.utils.snap() now allows you to define a snapping radius without using an array of values, like gsap.utils.snap({ increment: 500, radius: 100 }). See https://greensock.com/forums/topic/22297-allow-snap-util-to-use-radius-without-an-array-of-values/
    - FIXED: an error could be thrown in IE11 (and earlier) in certain rare cases (like when animating zIndex on a DOM element). See https://github.com/greensock/GSAP/issues/343
    - FIXED: if you place a call() (or zero-duration tween with an onComplete) on a timeline that is also zero-duration, its callback may not fire properly on the next tick.
    - FIXED: animating to a non-px value (like %) in a very rare case could result in 0 ins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
2020-02-21 3.2.0
    - NEW: MotionPathPlugin recognizes a new "alignOrigin" value that controls the point on the target that gets aligned with the path. Previously it was always the top left corner (of the bounding box). Setting an alignOrigin also automatically sets the transformOrigin to the corresponding place on the target for convenience. alignOrigin is an Array with progress values along the x and y axis, so [0.5, 0.5] would be in the center, [1, 0] would be the top right corner, etc. If you don't want to have the transformOrigin set to match automatically, pass false as the 3rd array element, like [0.5, 0.5, false].
    - NEW: MotionPathPlugin.getRelativePosition() method that calculates the x/y distan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
2020-03-20 3.2.5
    - IMPROVED: if you accidentally pass a number in to ScrambleTextPlugin as the new text, it'll cast it as a string.
    - IMPROVED: if you set extendTimeline: true on a gsap.registerEffect(), the timeline instance will be passed as the 3rd parameter to the effect.
    - IMPROVED: EaselPlugin will do its best to automatically set the cache on the target element according to its nominalBounds.
    - FIXED: setting the duration() of a Timeline didn't alter the timeScale properly (but it did if you set totalDuration()). See https://greensock.com/forums/topic/23240-timelineduration-question-or-issue/
    - FIXED: worked around a Firefox browser bug that interrupted pointermove events on Draggable items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
2020-06-14 3.3.2
    - NEW: ScrollTrigger accommodates pinning the same element multiple times! Just make sure you create the ScrollTriggers in the order they'll be pinned. See https://greensock.com/forums/topic/24429-scrolltrigger-pinning-element-both-top-and-bottom and https://greensock.com/forums/topic/24421-issues-with-multiple-pins-in-a-row/
    - IMPROVED: if a pinned ScrollTrigger's animation affects the pin element's transform, it now gets factored in to the final positioning of that pin.
    - IMPROVED: if you set up a toggleClass on a ScrollTrigger that has once: true, it will no longer toggle that class back onLeave (it will only happen onEnter because that's more intuitive).
    - FIXED: if you kill() a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
2020-06-14 3.3.3
    - FIXED: if you scroll really fast so that it goes past the start and end of the ScrollTrigger (onEnter and onLeave), it should prioritize the latter BUT if the onLeave is "none" or undefined, it makes the most intuitive sense to fire the onEnter action in this case. Likewise, if you scroll backward very quickly, it should do the same for the onEnterBack/onLeaveBack actions. See https://greensock.com/forums/topic/24445-scrolltrigger-version-332-doesnt-work-in-my-example/
    - FIXED: (related to above) if you have an onEnter and scroll quickly past BOTH of a ScrollTrigger's start/end positions (could happen especially if they're very close to each other), the onEnter may not fire at all.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
2020-07-08 3.4.0
    - NEW: ScrollTrigger.matchMedia() method that lets you easily set things up according to breakpoints and ScrollTrigger will automatically revert and kill any ScrollTriggers associated with the breakpoints that don't match. This makes it much simpler to make things behave differently on mobile devices and desktops, for example.
    - NEW: ScrollTrigger.scrollerProxy() method that makes it easier to integrate smooth scrolling effects by setting up proxy getter/setters for the scrollTop/scrollLeft properties of specific scrollers.
    - NEW: ScrollTrigger.saveStyles() method lets you record all the inline styles for any elements so that when ScrollTrigger does a refresh and reverts things inter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
2020-08-13 3.5.0
    - NEW: ScrollTrigger.clearMatchMedia() clears out matchMedia() breakpoints that were previously set via ScrollTrigger.matchMedia(). It doesn't kill the ScrollTriggers or animations themselves - it just no longer triggers anything at that break point.
    - NEW: gsap.ticker.deltaRatio() method gives a ratio of the change since the last tick based on a target fps (defaults to 60fps). For example, if the ticker is running at EXACTLY 60fps, that means each tick would be roughly 16.67 milliseconds apart, thus the default .deltaRatio() would be 1 (though that rarely happens perfectly). If you call gsap.ticker.deltaRatio(120) meaning you want the ratio based on 120fps, it would return 2 in this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
2020-08-26 3.5.1
    - FIXED: regression in 3.5.0 caused an error to be thrown in IE10 (related to new TypedArrays support). See https://greensock.com/forums/topic/23156-what-browsers-are-supported-by-gsap-3/
    - FIXED: some minor TypeScript definition file improvements
    - FIXED: if you pin something with ScrollTrigger on a page that initially has NO scrollbar and the contents fill the width, for example, it would end up showing a horizontal scrollbar because the width is set without the scrollbar and then one gets added due to the pinSpacing. So now ScrollTrigger will sense this condition and add overflow-y: scroll to the inline style. See https://greensock.com/forums/topic/25182-scrolltrigger-width-of-pag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
2020-09-09 Finished Current Pass of Documentation
2021-01-12 3.6.0
    - NEW: Flip Plugin smoothly animates between DOM layout changes. See https://greensock.com/flip
    - NEW: DrawSVGPlugin can now accommodate values outside of the 0-100% range, meaning you can loop/wrap strokes easily. We even shaved off some kb in the process.
    - NEW: you can set a ScrollTrigger's snap value to "labelsDirectional" and instead of snapping to the closest label, it will snap to the NEXT or PREVIOUS timeline label based on the velocity/direction of the timeline's playhead. This means users don't have to scroll beyond halfway between sections, for example - if they scroll even a little bit and release, it will go to the next/previous label in that direction.
    - NEW: hex color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
2021-03-25 3.6.1
    - NEW: you can define onStart, onComplete, and onInterrupt callbacks in the snap:{} object of a ScrollTrigger to sense when snapping starts, completes or gets interrupted. See https://greensock.com/forums/topic/27305-scrolltrigger-feature-request-onsnapinterrupt-callback/
    - NEW: you can prevent ScrollTrigger from factoring inertia into snapping by passing in inertia: false via a snap object, like snap: {snapTo: "labels", inertia: false, duration: 0.5}
    - NEW: MorphSVGPlugin.normalizeStrings() method that lets you feed in two path data strings and it'll return an Array with normalized strings that contain the same number of points.
    - NEW: you can append "nowrap" to a drawSVG value to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
2021-06-16 3.7.0
    - NEW: percentage-based position parameter options for timelines - A value like "-=25%" would overlap by 25% of the inserting animation's totalDuration, or "<25%" would insert it 25% into the previous animation. See docs for details. Related: https://github.com/greensock/GSAP/issues/444
    - NEW: gsap.utils.selector() returns a selector function that's scoped to a particular element (or React ref or Angular ElementRef) - no need to create a ref for each and every element you want to animate, for example!
    - NEW: gsap.utils.toArray() accepts an optional 2nd parameter, the Element on which .querySelectorAll() should be called (the scope) if selector text is passed in. Like gsap.utils.toArr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
2021-07-15 3.7.1
    - IMPROVED: made the "wheel" event listener passive in ScrollTrigger. See https://github.com/greensock/GSAP/issues/460
    - IMPROVED: made it possible to use CustomEase without loading GSAP.
    - IMPROVED: function-based inertia "end" values now receive the velocity as the 2nd parameter which makes it much easier to do directional snapping
    - IMPROVED: if you alter the repeatDelay() after the animation has already started, it maintains the playhead's local position as long as the parent timeline has smoothChildTiming enabled.
    - FIXED: if you call .update() with the "sticky" parameter true while dragging after the element has been changed in the document flow (repositioned), it may render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
2021-12-24 3.9.1
    - FIXED: if you do a .fromTo() and the "from" part has a numeric value (no unit) that does NOT have a default unit defined in gsap.config({units:{}}), it wouldn't get added automatically. Now it uses the unit from the current value in that case.
    - IMPROVED: Flip's "absolute" feature works better now with grid. It also assigns an explicit width/height to targets that aren't included in the "absolute" ones in order to prevent collapsing.
2022-03-29 3.10.0
    - NEW: Brand new ScrollSmoother plugin for doing smooth scrolling based on native scroll (for "Shockingly Green" and above Club GreenSock members). https://greensock.com/scrollsmoother
    - NEW: gsap.quickTo() for an optimized function that redirects an animation of a particular property to a new end value, like for mouse followers. https://greensock.com/docs/v3/GSAP/gsap.quickTo()
    - NEW: ScrollTrigger.normalizeScroll() that normalizes scroll across devices and handles it on the JS thread in order to keep things synchronized and prevent [most] mobile browsers from hiding/showing the address bar, overscroll bounce behavior, etc. https://greensock.com/docs/v3/Plugins/ScrollTrigger/static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
2022-03-30 3.10.1
    - IMPROVED: you can add a scrollSpeed multiplier to an Observer which is very useful if you want to invert the direction (scrollSpeed: -1)
    - FIXED: TypeScript definition file fixes, like Observer and ScrollSmoother needed to be added to the index.d.ts file. See https://greensock.com/forums/topic/31596-typescript-eslint-question/
    - FIXED: if you define a function-based "momentum" in ScrollTrigger.normalizeScroll({ momentum: self => {...} }) it wouldn't work properly (only numbers worked, not function-based values).
    - FIXED: default for the "type" of Observer is "wheel,touch,pointer" ("scroll" is not included anymore by default because it's better to opt-in due to the fact that drag-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
2022-04-12 3.10.3
    - NEW: ScrollSmoother now has a static .refresh() and instance-level .refresh() methods as a convenience (identical to ScrollTrigger.refresh() and smoother.scrollTrigger.refresh() but we found those weren't as intuitive).
    - IMPROVED: Observer will trigger an onMove when an onDrag occurs (rather than prioritizing the onDrag over onMove)
    - IMPROVED: if you set paused(true) on a ScrollSmoother, it'll now allow wheel scrolling on things other than the body (like modals). See https://greensock.com/forums/topic/31685-scrollsmoother-and-modal/
    - IMPROVED: if you forget to add a wrapper element for ScrollSmoother and it automatically generates one for you and then you (or your framework) c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
2022-04-22 3.10.4
    - IMPROVED: DrawSVGPlugin only warns once now when you use vector-effect="non-scaling-stroke" and scale something non-proportionally. See https://greensock.com/forums/topic/31881-warning-drawsvgplugin-and-vector-effect-property-in-safari-chrome-and-firefox/
    - IMPROVED: a ScrollTrigger.refresh() will now force a ScrollSmoother's wrapper element's scrollTop to 0 in order to work around an edge case where the browser automatically set it due to a hash in the URL for example. See https://greensock.com/forums/topic/31897-scroll-to-different-page/#comment-159550
    - IMPROVED: forced scroll-behavior to "auto" on <body>/<html> to override Bootstrap's "smooth" that it adds (and breaks things).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
2022-10-04 3.11.3
    - IMPROVED: if you use ScrollTrigger to pin something inside a pinnedContainer (and both have pinSpacing), it'll now adjust the padding/sizing of that pinnedContainer's pin-container element. So nested pinning has better support now.
    - IMPROVED: Previously, MotionPathHelper would only set the pathColor, pathWidth, and opacity if the path that was defined wasn't an svg <path> (if it created a new one), but now it'll honor those properties even if you're using an existing path. See https://greensock.com/forums/topic/34009-arguments-in-the-motionpathhelper-function-are-ignored/
    - IMPROVED: added a console.warn() for when you forget to define a "content" element for a ScrollSmoother.
    -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
2022-12-22 3.11.4
    - IMPROVED: SplitText, Draggable, and Observer are all now gsap.context()-aware. So for example if you SplitText within a context and then .revert() that context, the SplitText will also get reverted. And any Observer/Draggable that's created in a gsap.context() will get killed when that context gets reverted.
    - FIXED: added MotionPathHelper's kill() method to the TypeScript definitions
    - FIXED: if you pause a ScrollSmoother on a mobile/touch device that doesn't use touch events, it could trigger a "click" event when releasing the pointer/touch. See https://greensock.com/forums/topic/34265-scrollsmoother-causes-touch-scrolling-to-trigger-link-click/
    - FIXED: in a very unusual scena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
2023-06-06 3.12.0
    - NEW: Ever had ScrollTriggered animations at the very top of your page start out partially-scrubbed? Now you can clamp() them! Wrap your ScrollTrigger start/end values with "clamp()" to prevent them from "leaking" outside the bounds of the page. They'll never start before a scroll position of 0, nor will they finish after the maximum scroll. Clamped ScrollTriggers make all your "above the fold" elements start off in their native positions.
    - NEW: For ScrollSmoother, you can now wrap your data-speed value in "clamp()" to make the associated element start out in its natural position if it's within the viewport at the top of the page (meaning the resulting ScrollTrigger would otherwise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
2023-06-28 3.12.2
    - IMPROVED: on mobile devices where the address bar shows/hides and sometimes causes a jump after scrolling stops, particularly if there are multiple pins, ScrollTrigger now calculates positions based on 100vh instead of window.innerHeight because the former doesn't change whereas the latter does. This essentially avoids the "jump" in most cases (unless the elements on your page actually resize).
    - IMPROVED: consolidated "scroll" event listeners in ScrollTrigger so fewer are added to the main document. Functionally it makes no difference, but there is at least one synthetic test online that would [incorrectly] complain.
    - FIXED: regression in PixiPlugin caused an error related to fi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
2024-01-18 3.12.5
    - IMPROVED: ScrollTrigger's ignoreMobileResize is true by default now because a few versions back we switched to calculating the window height based on 100vh instead of window.innerHeight, so it really isn't necessary to force a .refresh() on mobile resize (address bar showing/hiding). This change improves performance on mobile devices because it skips the expensive refresh() when the address bar shows/hides.
    - IMPROVED: removed a DisplayObject check in PixiPlugin so that it's more compatible with the upcoming release of Pixi.js version 8. See https://github.com/greensock/GSAP/issues/561
    - IMPROVED: the anticipatePin feature works when scrolling in either direction (previously it wo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
2025-01-15 3.12.7
    - FIXED: regression in 3.12.6 that set pointer-events: none on ScrollTrigger pin spacers which caused descendents to stop responding to clicks and other pointer events.
    - FIXED: regression in 3.12.6 that could throw an error if you don’t pass a vars/config object to Flip.fit().
2025-05-21 KOMBI_A5 buttons
2025-06-12 PCB Rev2 (old)
2025-06-19 adjust power down
2025-08-14 WebUI calibration
2025-10-20 Bugfix GPIO_NUM_32 speed_mode LEDC
    [AIRmatic.ino]
2026-07-19 PCB Rev2 (new)
2026-07-30 PCB Rev2.0 (new)
2026-07-31 PCB Rev2.0
2026-08-23 Update PCB image reference in README
2026-09-15 fix don't call ISR APIs from Task Context
    [AIRmatic.ino]
2026-09-16 armed watchdog timer attached to loop()
2026-09-18 added sidebar with buttons
2026-09-19 fork: rnd-ash/W203-canbus ic code
2026-09-19 migrate to ARDUINO_CODE display API
2026-09-19 redirect CANBUS_COMMUNICATOR to mailbox
2026-09-20 ic: display steering wheel button presses
2026-10-15 Interrupt based CanRx
